Motor-Defection-Detect/safe-edge-ai-motor/firmware/stm32/r300_stm32_platform.c

/*
 * 이 파일의 역할: STM32F411 레지스터 직접 제어 - 96 MHz 클럭, GPIO, I2C2(MPU-6050), EXTI1(DRDY), TIM2/3/4,
 * ADC1+DMA2(전류), USART2+DMA1(Jetson 통신), USART1(AVR 진단 수신), SysTick. HAL 없이 로컬 레지스터 구조체 사용.
 * 읽기 순서: 6/13 (훑어보기용 - 함수 이름과 위 주석 위주로 보고 비트 값은 RM0383 참고)
 * 다음에 볼 곳: edge/r300_link/runtime.py — 이제 Jetson(엣지) 쪽에서 이 프레임들을 어떻게 받는지
 * 관련: firmware/stm32/include/r300_stm32f411_regs.h(레지스터 정의), firmware/stm32/include/r300_board_config.h(보드 상수)
 */
#include "r300_board_config.h"
#include "r300_link.h"
#include "r300_stm32_platform.h"
#include "r300_stm32f411_regs.h"

#define RCC_CR_PLLON R300_BIT(24)
#define RCC_CR_PLLRDY R300_BIT(25)
#define RCC_CFGR_SW_PLL 2u
#define RCC_CFGR_SWS_MASK (3u << 2)
#define RCC_CFGR_SWS_PLL (2u << 2)
#define RCC_CFGR_PPRE1_DIV2 (4u << 10)
#define PWR_CR_VOS_SCALE1 (3u << 14)
#define PWR_CSR_VOSRDY R300_BIT(14)
#define I2C_CR1_PE R300_BIT(0)
#define I2C_CR1_START R300_BIT(8)
#define I2C_CR1_STOP R300_BIT(9)
#define I2C_CR1_ACK R300_BIT(10)
#define I2C_SR1_SB R300_BIT(0)
#define I2C_SR1_ADDR R300_BIT(1)
#define I2C_SR1_BTF R300_BIT(2)
#define I2C_SR1_RXNE R300_BIT(6)
#define I2C_SR1_TXE R300_BIT(7)
#define I2C_SR1_ERRORS (R300_BIT(8) | R300_BIT(9) | R300_BIT(10) | R300_BIT(11) | R300_BIT(14))
#define I2C_SR2_BUSY R300_BIT(1)
#define MPU6050_REG_SMPLRT_DIV 0x19u
#define MPU6050_REG_CONFIG 0x1au
#define MPU6050_REG_GYRO_CONFIG 0x1bu
#define MPU6050_REG_ACCEL_CONFIG 0x1cu
#define MPU6050_REG_INT_ENABLE 0x38u
#define MPU6050_REG_INT_STATUS 0x3au
#define MPU6050_REG_PWR_MGMT_1 0x6bu
#define MPU6050_REG_WHO_AM_I 0x75u
#define USART_SR_ERRORS 0x0fu
#define USART_SR_RXNE R300_BIT(5)
#define DMA_STREAM_EN R300_BIT(0)
#define DMA_STREAM0_ERRORS (R300_BIT(0) | R300_BIT(2) | R300_BIT(3))
#define DMA_STREAM5_ERRORS (R300_BIT(6) | R300_BIT(8) | R300_BIT(9))
#define DMA_STREAM5_CLEAR 0x00000f40u
#define DMA_STREAM6_ERRORS (R300_BIT(16) | R300_BIT(18) | R300_BIT(19))
#define DMA_STREAM6_CLEAR 0x003d0000u
#define R300_HEALTH_RX_BYTES 64u

static volatile uint16_t adc_samples[R300_BLOCK_SAMPLES];
static volatile uint8_t health_rx[R300_HEALTH_RX_BYTES];
static volatile bool vibration_pending;
static volatile uint32_t vibration_timestamp_us;
static uint16_t last_adc_index;
static uint16_t last_health_rx_index;
static uint32_t last_adc_us;
static uint32_t last_vibration_us;
static uint32_t last_identity_check_us;
static volatile uint32_t vibration_overruns;
static uint32_t adc_overruns;
static uint32_t sensor_bus_errors;
static uint32_t uart_errors;
static uint32_t avr_uart_errors;
static bool adc_seen;
static bool vibration_seen;
static bool sensor_identity_valid;
static volatile uint32_t system_ms;

_Static_assert(R300_APB2_HZ % R300_AVR_DIAGNOSTIC_BAUD == 0u,
               "AVR diagnostic baud must divide the USART1 clock exactly");
_Static_assert(R300_HEALTH_RX_BYTES >= R300_HEALTH_BYTES + R300_MOTOR_COMMAND_BYTES,
               "Jetson RX ring must hold one complete HEALTH and command burst");
_Static_assert(R300_SYSCLK_HZ % R300_SAMPLE_RATE_HZ == 0u,
               "sample rate must divide the timer clock exactly");
_Static_assert(R300_SYSCLK_HZ /
               ((R300_MOTOR_PWM_PRESCALER + 1u) * R300_MOTOR_PWM_PERIOD_TICKS) ==
               R300_MOTOR_PWM_HZ, "PWM constants must produce the requested frequency");

/*
 * 레지스터의 특정 비트가 지정한 상태(set=true면 1, false면 0)가 될 때까지 제한 횟수만큼 기다린다. 하드웨어가 응답하지 않아도 무한 대기하지 않도록 타임아웃이 있다.
 */
static bool wait_bits(volatile uint32_t *reg, uint32_t mask, bool set)
{
    for (uint32_t timeout = 1000000u; timeout != 0u; --timeout)
        if (((*reg & mask) != 0u) == set) return true;
    return false;
}

/* 레지스터의 마스크된 필드가 기대 값이 될 때까지 제한 횟수만큼 기다린다(클럭 소스 전환 확인 등). */
static bool wait_value(volatile uint32_t *reg, uint32_t mask, uint32_t value)
{
    for (uint32_t timeout = 1000000u; timeout != 0u; --timeout)
        if ((*reg & mask) == value) return true;
    return false;
}

/* GPIO 핀 모드 설정(0 입력, 1 출력, 2 대체기능, 3 아날로그). 핀당 2비트 필드만 바꾼다. */
static void gpio_mode(r300_gpio_regs_t *gpio, uint8_t pin, uint32_t mode)
{
    gpio->MODER = (gpio->MODER & ~(3u << (pin * 2u))) | (mode << (pin * 2u));
}

/* GPIO 출력 속도 필드(핀당 2비트)를 설정한다. */
static void gpio_speed(r300_gpio_regs_t *gpio, uint8_t pin, uint32_t speed)
{
    gpio->OSPEEDR = (gpio->OSPEEDR & ~(3u << (pin * 2u))) | (speed << (pin * 2u));
}

/* GPIO 풀업/풀다운 필드(핀당 2비트)를 설정한다. */
static void gpio_pull(r300_gpio_regs_t *gpio, uint8_t pin, uint32_t pull)
{
    gpio->PUPDR = (gpio->PUPDR & ~(3u << (pin * 2u))) | (pull << (pin * 2u));
}

/* 핀의 대체기능(AF) 번호를 설정한다. AFR은 핀 0~7과 8~15가 두 레지스터로 나뉘고 핀당 4비트다. */
static void gpio_af(r300_gpio_regs_t *gpio, uint8_t pin, uint8_t af)
{
    uint8_t bank = pin >= 8u ? 1u : 0u;
    uint8_t shift = (uint8_t)((pin & 7u) * 4u);
    gpio->AFR[bank] = (gpio->AFR[bank] & ~(15u << shift)) | ((uint32_t)af << shift);
}

/*
 * I2C 상태 비트를 기다린다. 오류 플래그가 뜨거나 시간이 초과되면 sensor_bus_errors를 올리고 STOP을 보낸 뒤 false를 반환한다.
 * 이 카운터는 한번 올라가면 건강 판정(platform_healthy)을 계속 실패시킨다.
 */
static bool i2c_wait(volatile uint32_t *reg, uint32_t mask, bool set)
{
    for (uint32_t timeout = 100000u; timeout != 0u; --timeout) {
        if ((R300_I2C2->SR1 & I2C_SR1_ERRORS) != 0u) {
            ++sensor_bus_errors;
            R300_I2C2->CR1 |= I2C_CR1_STOP;
            R300_I2C2->SR1 &= ~I2C_SR1_ERRORS;
            return false;
        }
        if (((*reg & mask) != 0u) == set) return true;
    }
    ++sensor_bus_errors;
    R300_I2C2->CR1 |= I2C_CR1_STOP;
    return false;
}

/* START 조건을 보내고 7비트 주소 + R/W 비트를 전송해 ADDR 응답을 기다린다. */
static bool i2c_address(uint8_t address, bool read)
{
    R300_I2C2->CR1 |= I2C_CR1_START;
    if (!i2c_wait(&R300_I2C2->SR1, I2C_SR1_SB, true)) return false;
    R300_I2C2->DR = (uint32_t)((address << 1) | (read ? 1u : 0u));
    return i2c_wait(&R300_I2C2->SR1, I2C_SR1_ADDR, true);
}

/* STM32 I2C 규칙에 따라 SR1 다음 SR2를 읽어 ADDR 플래그를 지운다(읽기 순서 자체가 의미 있음). */
static void i2c_clear_address(void)
{
    volatile uint32_t clear = R300_I2C2->SR1;
    clear = R300_I2C2->SR2;
    (void)clear;
}

/* MPU-6050 레지스터 1개에 값을 쓴다(레지스터 주소 + 데이터 전송 후 STOP). */
static bool mpu_write(uint8_t reg, uint8_t value)
{
    if (!i2c_wait(&R300_I2C2->SR2, I2C_SR2_BUSY, false) ||
        !i2c_address(R300_MPU6050_ADDRESS, false)) return false;
    i2c_clear_address();
    if (!i2c_wait(&R300_I2C2->SR1, I2C_SR1_TXE, true)) return false;
    R300_I2C2->DR = reg;
    if (!i2c_wait(&R300_I2C2->SR1, I2C_SR1_TXE, true)) return false;
    R300_I2C2->DR = value;
    if (!i2c_wait(&R300_I2C2->SR1, I2C_SR1_BTF, true)) return false;
    R300_I2C2->CR1 |= I2C_CR1_STOP;
    return true;
}

/*
 * MPU-6050 레지스터를 연속으로 읽는다(주소 쓰기 -> repeated START -> 읽기). STM32F4 I2C는 수신 바이트 수에 따라
 * ACK/STOP 타이밍을 직접 맞춰야 하므로 1바이트, 2바이트 이상, 마지막 3바이트의 처리가 각각 다르다.
 */
static bool mpu_read(uint8_t reg, uint8_t *data, size_t bytes)
{
    if (!data || bytes == 0u || !i2c_wait(&R300_I2C2->SR2, I2C_SR2_BUSY, false) ||
        !i2c_address(R300_MPU6050_ADDRESS, false)) return false;
    i2c_clear_address();
    if (!i2c_wait(&R300_I2C2->SR1, I2C_SR1_TXE, true)) return false;
    R300_I2C2->DR = reg;
    if (!i2c_wait(&R300_I2C2->SR1, I2C_SR1_BTF, true) ||
        !i2c_address(R300_MPU6050_ADDRESS, true)) return false;
    if (bytes == 1u) {
        R300_I2C2->CR1 &= ~I2C_CR1_ACK;
        i2c_clear_address();
        R300_I2C2->CR1 |= I2C_CR1_STOP;
        if (!i2c_wait(&R300_I2C2->SR1, I2C_SR1_RXNE, true)) return false;
        data[0] = (uint8_t)R300_I2C2->DR;
    } else {
        R300_I2C2->CR1 |= I2C_CR1_ACK;
        i2c_clear_address();
        size_t index = 0u;
        while (bytes - index > 3u) {
            if (!i2c_wait(&R300_I2C2->SR1, I2C_SR1_RXNE, true)) return false;
            data[index++] = (uint8_t)R300_I2C2->DR;
        }
        if (!i2c_wait(&R300_I2C2->SR1, I2C_SR1_BTF, true)) return false;
        R300_I2C2->CR1 &= ~I2C_CR1_ACK;
        data[index++] = (uint8_t)R300_I2C2->DR;
        R300_I2C2->CR1 |= I2C_CR1_STOP;
        data[index++] = (uint8_t)R300_I2C2->DR;
        if (!i2c_wait(&R300_I2C2->SR1, I2C_SR1_RXNE, true)) return false;
        data[index] = (uint8_t)R300_I2C2->DR;
    }
    R300_I2C2->CR1 |= I2C_CR1_ACK;
    return true;
}

/*
 * 내부 16 MHz HSI를 PLL로 96 MHz까지 올린다(PLLM=16, PLLN=192, PLLP=2, PLLQ=4). 전압 스케일1, 플래시 대기 상태,
 * APB1 분주 2(48 MHz)를 함께 설정하고 PLL 락/클럭 전환을 확인한다. 실패하면 false를 반환한다.
 */
static bool clock_init(void)
{
    R300_RCC->APB1ENR |= R300_BIT(28);
    R300_PWR->CR = (R300_PWR->CR & ~(3u << 14)) | PWR_CR_VOS_SCALE1;
    if (!wait_bits(&R300_PWR->CSR, PWR_CSR_VOSRDY, true)) return false;
    R300_RCC->PLLCFGR = 16u | (192u << 6) | (4u << 24);
    R300_FLASH->ACR = R300_BIT(10) | R300_BIT(9) | R300_BIT(8) | 3u;
    R300_RCC->CR |= RCC_CR_PLLON;
    if (!wait_bits(&R300_RCC->CR, RCC_CR_PLLRDY, true)) return false;
    R300_RCC->CFGR = RCC_CFGR_PPRE1_DIV2 | RCC_CFGR_SW_PLL;
    return wait_value(&R300_RCC->CFGR, RCC_CFGR_SWS_MASK, RCC_CFGR_SWS_PLL);
}

/*
 * 시스템 전체 초기화 후 성공 여부를 반환한다. 순서: 클럭 -> 주변장치 클럭 -> GPIO(안전 레벨을 출력 모드 전에 미리 기록) ->
 * TIM2(1 MHz 타임스탬프) -> I2C2/MPU-6050(WHO_AM_I 확인, 1 kHz, +/-16 g, DRDY) -> EXTI1(PB1) -> SysTick(1 ms) ->
 * TIM4 PWM(PB6) -> TIM3 트리거 ADC1 + DMA2(전류 1 kHz) -> USART2+DMA1(Jetson, 921600 bps) -> USART1(AVR 진단 수신).
 * 센서 초기화가 실패하면 false이고, main은 PWM/HEARTBEAT을 끈 채 멈춘다.
 */
bool r300_stm32_platform_init(void)
{
    if (!clock_init()) return false;
    R300_RCC->AHB1ENR |= R300_BIT(0) | R300_BIT(1) | R300_BIT(21) | R300_BIT(22);
    R300_RCC->APB1ENR |= R300_BIT(0) | R300_BIT(1) | R300_BIT(2) | R300_BIT(17) | R300_BIT(22);
    R300_RCC->APB2ENR |= R300_BIT(4) | R300_BIT(8) | R300_BIT(14);

    gpio_mode(R300_GPIOA, 0u, 3u);
    for (uint8_t pin = 2u; pin <= 3u; ++pin) {
        gpio_mode(R300_GPIOA, pin, 2u); gpio_speed(R300_GPIOA, pin, 2u); gpio_af(R300_GPIOA, pin, 7u);
    }
    for (uint8_t pin = 9u; pin <= 10u; ++pin) {
        gpio_mode(R300_GPIOA, pin, 2u); gpio_speed(R300_GPIOA, pin, 2u); gpio_af(R300_GPIOA, pin, 7u);
    }
    /* Preload inactive/safe GPIO levels before their output modes can drive a pin. */
    R300_GPIOB->BSRR = R300_BIT(23) | R300_BIT(24);
    gpio_mode(R300_GPIOB, 1u, 0u);
    gpio_mode(R300_GPIOB, 6u, 2u); gpio_speed(R300_GPIOB, 6u, 2u); gpio_af(R300_GPIOB, 6u, 2u);
    gpio_mode(R300_GPIOB, 7u, 1u); gpio_mode(R300_GPIOB, 8u, 1u);
    gpio_mode(R300_GPIOB, 10u, 2u); gpio_speed(R300_GPIOB, 10u, 2u);
    gpio_af(R300_GPIOB, 10u, 4u); gpio_pull(R300_GPIOB, 10u, 1u);
    R300_GPIOB->OTYPER |= R300_BIT(10u);
    /* NUCLEO-F411RE LQFP64 has no PB11; PB3 exposes I2C2_SDA on AF9. */
    gpio_mode(R300_GPIOB, 3u, 2u); gpio_speed(R300_GPIOB, 3u, 2u);
    gpio_af(R300_GPIOB, 3u, 9u); gpio_pull(R300_GPIOB, 3u, 1u);
    R300_GPIOB->OTYPER |= R300_BIT(3u);

    /* Start the 1 MHz source clock before sensor initialization. */
    R300_TIM2->PSC = 95u; R300_TIM2->ARR = 0xffffffffu;
    R300_TIM2->EGR = 1u; R300_TIM2->SR = 0u; R300_TIM2->CR1 = 1u;
    R300_RCC->APB1RSTR |= R300_BIT(22); R300_RCC->APB1RSTR &= ~R300_BIT(22);
    R300_I2C2->CR2 = 48u;
    R300_I2C2->CCR = R300_BIT(15) | 40u; /* 400 kHz fast mode, duty 2. */
    R300_I2C2->TRISE = 15u;
    R300_I2C2->CR1 = I2C_CR1_PE | I2C_CR1_ACK;
    uint8_t identity = 0u;
    if (!mpu_read(MPU6050_REG_WHO_AM_I, &identity, 1u) ||
        identity != R300_MPU6050_WHO_AM_I ||
        !mpu_write(MPU6050_REG_PWR_MGMT_1, 0x01u) ||
        !mpu_write(MPU6050_REG_SMPLRT_DIV, R300_MPU6050_SMPLRT_DIV) ||
        !mpu_write(MPU6050_REG_CONFIG, R300_MPU6050_CONFIG) ||
        !mpu_write(MPU6050_REG_GYRO_CONFIG, 0x00u) ||
        !mpu_write(MPU6050_REG_ACCEL_CONFIG, R300_MPU6050_ACCEL_CONFIG) ||
        !mpu_write(MPU6050_REG_INT_ENABLE, 0x01u) ||
        !mpu_read(MPU6050_REG_ACCEL_CONFIG, &identity, 1u) ||
        identity != R300_MPU6050_ACCEL_CONFIG) return false;
    R300_SYSCFG->EXTICR[0] = (R300_SYSCFG->EXTICR[0] & ~(15u << 4)) | (1u << 4);
    R300_EXTI->PR = R300_BIT(1);
    R300_EXTI->IMR |= R300_BIT(1);
    R300_EXTI->RTSR |= R300_BIT(1);
    R300_NVIC->ISER[0] = R300_BIT(7);
    sensor_identity_valid = true;

    R300_SYSTICK->RVR = R300_SYSCLK_HZ / 1000u - 1u;
    R300_SYSTICK->CVR = 0u;
    R300_SYSTICK->CSR = R300_BIT(2) | R300_BIT(1) | R300_BIT(0);
    R300_TIM4->PSC = 0u; R300_TIM4->ARR = R300_MOTOR_PWM_PERIOD_TICKS - 1u;
    R300_TIM4->CCMR1 = (6u << 4) | R300_BIT(3);
    /* R300_HW_TUNE: CC1P inverts PWM for a verified active-low module input. */
    R300_TIM4->CCER = R300_LR7843_PWM_ACTIVE_HIGH ? 1u : 3u;
    R300_TIM4->CCR1 = 0u; R300_TIM4->CR1 = R300_BIT(7) | 1u;

    R300_DMA2->STREAM[0].CR = 0u;
    R300_DMA2->LIFCR = 0x3du;
    R300_DMA2->STREAM[0].NDTR = R300_BLOCK_SAMPLES;
    R300_DMA2->STREAM[0].PAR = (uint32_t)(uintptr_t)&R300_ADC1->DR;
    R300_DMA2->STREAM[0].M0AR = (uint32_t)(uintptr_t)adc_samples;
    R300_DMA2->STREAM[0].CR = R300_BIT(13) | R300_BIT(11) | R300_BIT(10) |
                                     R300_BIT(8) | DMA_STREAM_EN;
    R300_ADC_COMMON->CCR = R300_BIT(16);
    R300_ADC1->SMPR2 = 4u; R300_ADC1->SQR3 = 0u;
    R300_ADC1->CR2 = (8u << 24) | R300_BIT(28) | R300_BIT(14) | R300_BIT(9) | 1u;
    R300_TIM3->PSC = 0u; R300_TIM3->ARR = (R300_SYSCLK_HZ / R300_SAMPLE_RATE_HZ) - 1u;
    R300_TIM3->CR2 = 2u << 4; R300_TIM3->EGR = 1u; R300_TIM3->CR1 = 1u;

    R300_DMA1->STREAM[5].CR = 0u;
    R300_DMA1->HIFCR = DMA_STREAM5_CLEAR;
    R300_DMA1->STREAM[5].NDTR = R300_HEALTH_RX_BYTES;
    R300_DMA1->STREAM[5].PAR = (uint32_t)(uintptr_t)&R300_USART2->DR;
    R300_DMA1->STREAM[5].M0AR = (uint32_t)(uintptr_t)health_rx;
    R300_DMA1->STREAM[5].CR = (4u << 25) | R300_BIT(10) | R300_BIT(8) |
                                     DMA_STREAM_EN;
    R300_USART2->BRR = 52u;
    R300_USART2->CR3 = R300_BIT(7) | R300_BIT(6);
    R300_USART2->CR1 = R300_BIT(13) | R300_BIT(3) | R300_BIT(2);
    R300_USART1->BRR = R300_APB2_HZ / R300_AVR_DIAGNOSTIC_BAUD;
    R300_USART1->CR1 = R300_BIT(13) | R300_BIT(2);
    return sensor_bus_errors == 0u;
}

/*
 * 플랫폼 건강 판정(센서 준비의 기반). 100 ms마다 MPU-6050 WHO_AM_I를 다시 읽어 센서 분리를 감지하고,
 * I2C/UART/DMA/ADC 오류, 오버런, 그리고 두 센서 스트림이 100 ms 넘게 멈췄는지를 모두 확인한다.
 * 카운터형 오류는 한번 발생하면 그대로 남아 이 함수가 계속 false를 반환한다.
 */
bool r300_stm32_platform_healthy(void)
{
    uint32_t now_us = R300_TIM2->CNT;
    const uint32_t adc_dma_errors = R300_DMA2->LISR & DMA_STREAM0_ERRORS;
    const uint32_t uart_dma_errors = R300_DMA1->HISR &
        (DMA_STREAM5_ERRORS | DMA_STREAM6_ERRORS);
    const uint32_t adc_errors = R300_ADC1->SR & R300_BIT(5);
    if (sensor_identity_valid &&
        (uint32_t)(now_us - last_identity_check_us) >= R300_SENSOR_IDENTITY_CHECK_US) {
        uint32_t errors_before = sensor_bus_errors;
        last_identity_check_us = now_us;
        uint8_t identity = 0u;
        if (!mpu_read(MPU6050_REG_WHO_AM_I, &identity, 1u) ||
            identity != R300_MPU6050_WHO_AM_I) {
            if (sensor_bus_errors == errors_before) ++sensor_bus_errors;
            sensor_identity_valid = false;
        }
    }
    return sensor_identity_valid && sensor_bus_errors == 0u && uart_errors == 0u && adc_seen && vibration_seen &&
           vibration_overruns == 0u && adc_overruns == 0u &&
           adc_dma_errors == 0u && uart_dma_errors == 0u && adc_errors == 0u &&
           (uint32_t)(now_us - last_adc_us) <= R300_SENSOR_STALE_US &&
           (uint32_t)(now_us - last_vibration_us) <= R300_SENSOR_STALE_US;
}

/* STM32 진단 프레임에 실을 플랫폼 오류/오버런 카운터와 DMA/ADC 오류 플래그를 현재 값으로 복사한다. */
void r300_stm32_platform_diagnostics(r300_stm32_platform_diagnostics_t *diagnostics)
{
    if (!diagnostics) return;
    diagnostics->vibration_overruns = vibration_overruns;
    diagnostics->adc_overruns = adc_overruns;
    diagnostics->sensor_bus_errors = sensor_bus_errors;
    diagnostics->uart_errors = uart_errors;
    diagnostics->avr_uart_errors = avr_uart_errors;
    diagnostics->adc_dma_errors = R300_DMA2->LISR & DMA_STREAM0_ERRORS;
    diagnostics->uart_dma_errors = R300_DMA1->HISR &
                                   (DMA_STREAM5_ERRORS | DMA_STREAM6_ERRORS);
    diagnostics->adc_peripheral_errors = R300_ADC1->SR & R300_BIT(5);
}

/*
 * MPU-6050 데이터 준비(DRDY, PB1 상승 엣지) 인터럽트. 가능한 짧게 TIM2 타임스탬프만 기록한다.
 * I2C 읽기는 인터럽트에서 하지 않고 메인 루프(vibration_poll)가 하며, 이미 대기 중이면 overrun으로 센다.
 */
void EXTI1_IRQHandler(void)
{
    R300_EXTI->PR = R300_BIT(1);
    if (vibration_pending) ++vibration_overruns;
    vibration_timestamp_us = R300_TIM2->CNT;
    vibration_pending = true;
}

/* 1 ms마다 system_ms를 증가시킨다(r300_stm32_millis의 기반, 타임아웃 판정용 밀리초 시간). */
void SysTick_Handler(void)
{
    ++system_ms;
}

/*
 * DRDY 이벤트가 대기 중이면 MPU-6050에서 7바이트(INT_STATUS + 가속도 6바이트)를 읽어 X/Y/Z로 변환한다.
 * 타임스탬프는 읽은 시각이 아니라 ISR이 기록한 DRDY 시각이다. I2C 오류가 한 번이라도 있었으면 읽지 않는다.
 */
bool r300_stm32_vibration_poll(int16_t xyz[3], uint32_t *timestamp_us)
{
    uint8_t raw[7];
    uint32_t event_timestamp_us;
    if (!xyz || !timestamp_us || !vibration_pending || sensor_bus_errors != 0u) return false;
    event_timestamp_us = vibration_timestamp_us;
    vibration_pending = false;
    /* INT_STATUS first clears the data-ready latch in the same burst. */
    if (!mpu_read(MPU6050_REG_INT_STATUS, raw, sizeof(raw))) return false;
    for (size_t axis = 0; axis < 3u; ++axis)
        xyz[axis] = (int16_t)(((uint16_t)raw[axis * 2u + 1u] << 8) |
                              (uint16_t)raw[axis * 2u + 2u]);
    *timestamp_us = event_timestamp_us;
    last_vibration_us = *timestamp_us;
    vibration_seen = true;
    return true;
}

/*
 * ADC DMA 링(128개)의 최신 값을 폴링한다. DMA가 진행했으면 가장 최근 샘플을 돌려주고, 마지막 폴링 이후
 * 128 ms(링 한 바퀴) 이상 지났으면 adc_overruns를 올린다. 중간 샘플은 건너뛸 수 있다(최신 값 유지 방식).
 */
bool r300_stm32_current_poll(uint16_t *adc_count)
{
    uint16_t index;
    uint32_t now_us;
    uint32_t elapsed_us;
    if (!adc_count) return false;
    now_us = R300_TIM2->CNT;
    elapsed_us = now_us - last_adc_us;
    index = (uint16_t)((R300_BLOCK_SAMPLES - R300_DMA2->STREAM[0].NDTR) % R300_BLOCK_SAMPLES);
    if (index == last_adc_index && (!adc_seen || elapsed_us < R300_FRAME_PERIOD_MS * 1000u))
        return false;
    /* Latest-value hold permits skipped intermediate ADC samples; only a full
       128-sample DMA ring overwrite loses ownership. */
    if (adc_seen && elapsed_us >= R300_FRAME_PERIOD_MS * 1000u) ++adc_overruns;
    last_adc_index = index;
    adc_seen = true;
    last_adc_us = now_us;
    *adc_count = adc_samples[index == 0u ? R300_BLOCK_SAMPLES - 1u : index - 1u];
    return true;
}

/*
 * Jetson UART 수신용 DMA 순환 버퍼(64바이트)에서 읽을 바이트가 있으면 하나 꺼낸다. DMA 쓰기 위치(NDTR)와 읽기 위치를 비교하는
 * 폴링 방식이다. UART 오류 플래그가 있으면 데이터 레지스터를 읽어 지우고 uart_errors를 올린다.
 */
bool r300_stm32_health_byte(uint8_t *byte)
{
    uint16_t write_index;
    uint32_t status;
    if (!byte) return false;
    status = R300_USART2->SR;
    if ((status & USART_SR_ERRORS) != 0u) {
        (void)R300_USART2->DR;
        ++uart_errors;
        return false;
    }
    write_index = (uint16_t)((R300_HEALTH_RX_BYTES -
        R300_DMA1->STREAM[5].NDTR) % R300_HEALTH_RX_BYTES);
    if (write_index == last_health_rx_index) return false;
    *byte = health_rx[last_health_rx_index];
    last_health_rx_index = (uint16_t)((last_health_rx_index + 1u) %
                                      R300_HEALTH_RX_BYTES);
    return true;
}

/*
 * AVR 진단 UART(USART1)에서 수신된 바이트가 있으면 1바이트 반환한다(DMA 없이 RXNE 폴링). 오류가 있으면 avr_uart_errors를 올린다.
 */
bool r300_stm32_avr_diag_byte(uint8_t *byte)
{
    uint32_t status;
    if (!byte) return false;
    status = R300_USART1->SR;
    if ((status & USART_SR_ERRORS) != 0u) {
        (void)R300_USART1->DR;
        ++avr_uart_errors;
        return false;
    }
    if ((status & USART_SR_RXNE) == 0u) return false;
    *byte = (uint8_t)R300_USART1->DR;
    return true;
}

/*
 * Jetson 쪽 송신 DMA(DMA1 Stream6)가 진행 중인지 반환한다. 호출될 때 DMA 오류 플래그도 uart_errors에 반영한다.
 */
bool r300_stm32_uart_tx_busy(void)
{
    if ((R300_DMA1->HISR & DMA_STREAM6_ERRORS) != 0u) ++uart_errors;
    return (R300_DMA1->STREAM[6].CR & DMA_STREAM_EN) != 0u;
}

/*
 * 프레임을 USART2 DMA로 비동기 송신 시작한다. 이미 송신 중이거나 크기가 0/65535 초과면 false.
 * data 버퍼는 송신이 끝날 때까지 유지되어야 한다(runtime의 tx_frame이 그 역할).
 */
bool r300_stm32_uart_tx_start(const uint8_t *data, size_t bytes)
{
    if (!data || bytes == 0u || bytes > 65535u || r300_stm32_uart_tx_busy()) return false;
    R300_DMA1->HIFCR = DMA_STREAM6_CLEAR;
    R300_DMA1->STREAM[6].PAR = (uint32_t)(uintptr_t)&R300_USART2->DR;
    R300_DMA1->STREAM[6].M0AR = (uint32_t)(uintptr_t)data;
    R300_DMA1->STREAM[6].NDTR = (uint32_t)bytes;
    R300_DMA1->STREAM[6].CR = (4u << 25) | R300_BIT(10) | R300_BIT(6) | DMA_STREAM_EN;
    return true;
}

/*
 * HEARTBEAT 출력 PB8을 level로 설정한다. BSRR을 쓰므로 다른 핀에 영향을 주지 않는다. AVR PE4로 연결된다.
 */
void r300_stm32_heartbeat_write(bool level)
{
    R300_GPIOB->BSRR = R300_BIT(level ? 8u : 24u);
}

/* TIM4 CH1(PB6) PWM compare 값을 기록한다. 주기 틱 수를 넘는 값은 100% 듀티로 제한한다. */
void r300_stm32_pwm_write(uint16_t compare)
{
    R300_TIM4->CCR1 = compare > R300_MOTOR_PWM_PERIOD_TICKS ?
                      R300_MOTOR_PWM_PERIOD_TICKS : compare;
}

/* SysTick 기반 밀리초 카운터를 반환한다(약 49.7일마다 wrap, 시간 차는 uint32 뺄셈으로 비교). */
uint32_t r300_stm32_millis(void)
{
    return system_ms;
}
