Motor-Defection-Detect/safe-edge-ai-motor/(commit log)

2026-09-02 complete: v0 complete
    [pinmap.generated.csv]
2026-09-02 fix: change Necleo board
    [pinmap.generated.csv]
